MarcelRankwiler/TP21/OwnCars/21286/Chassis.png

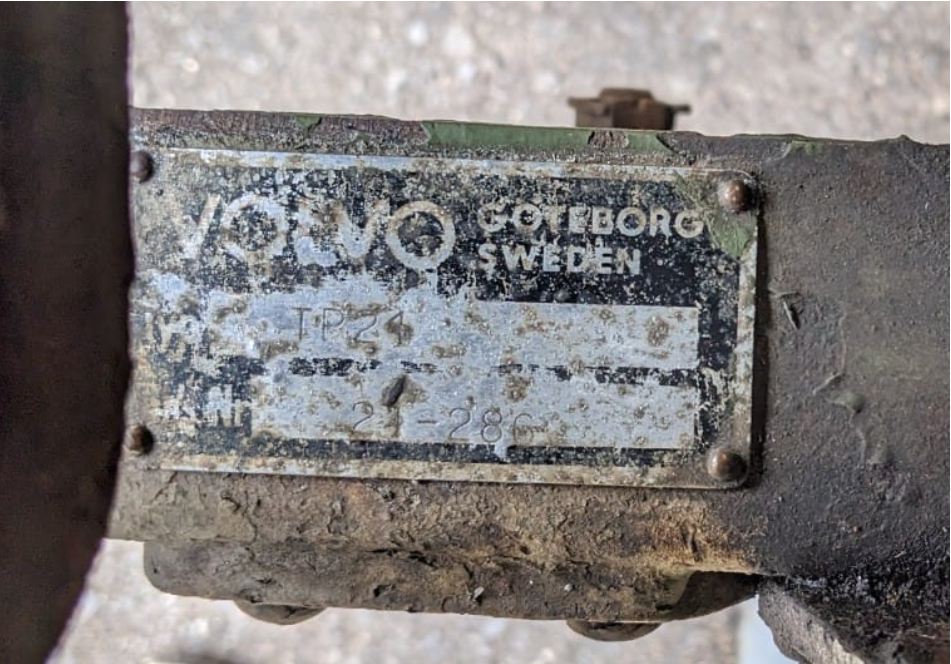
OwnCars/21286/Chassis.png
