MarcelRankwiler/TP21/Pictures/Fusebox.jpg

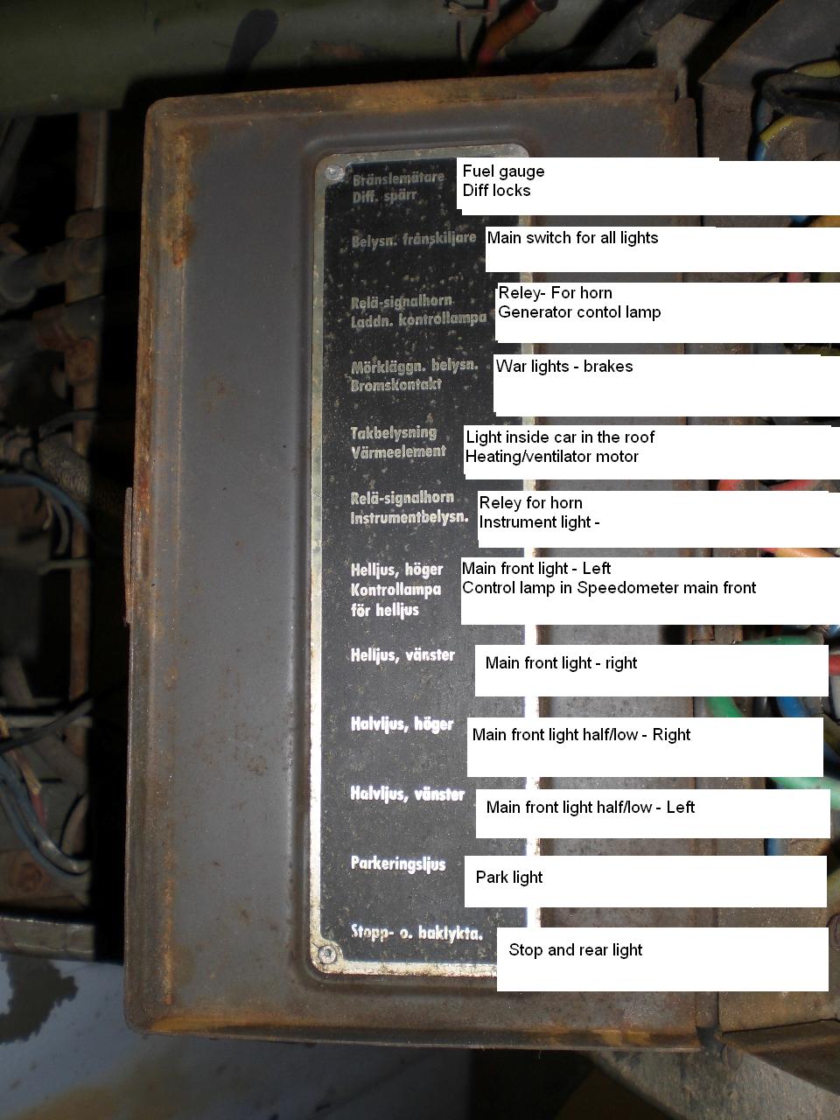
Pictures/Fusebox.jpg
