MarcelRankwiler/TP21/OwnCars/21286/21286.pdf

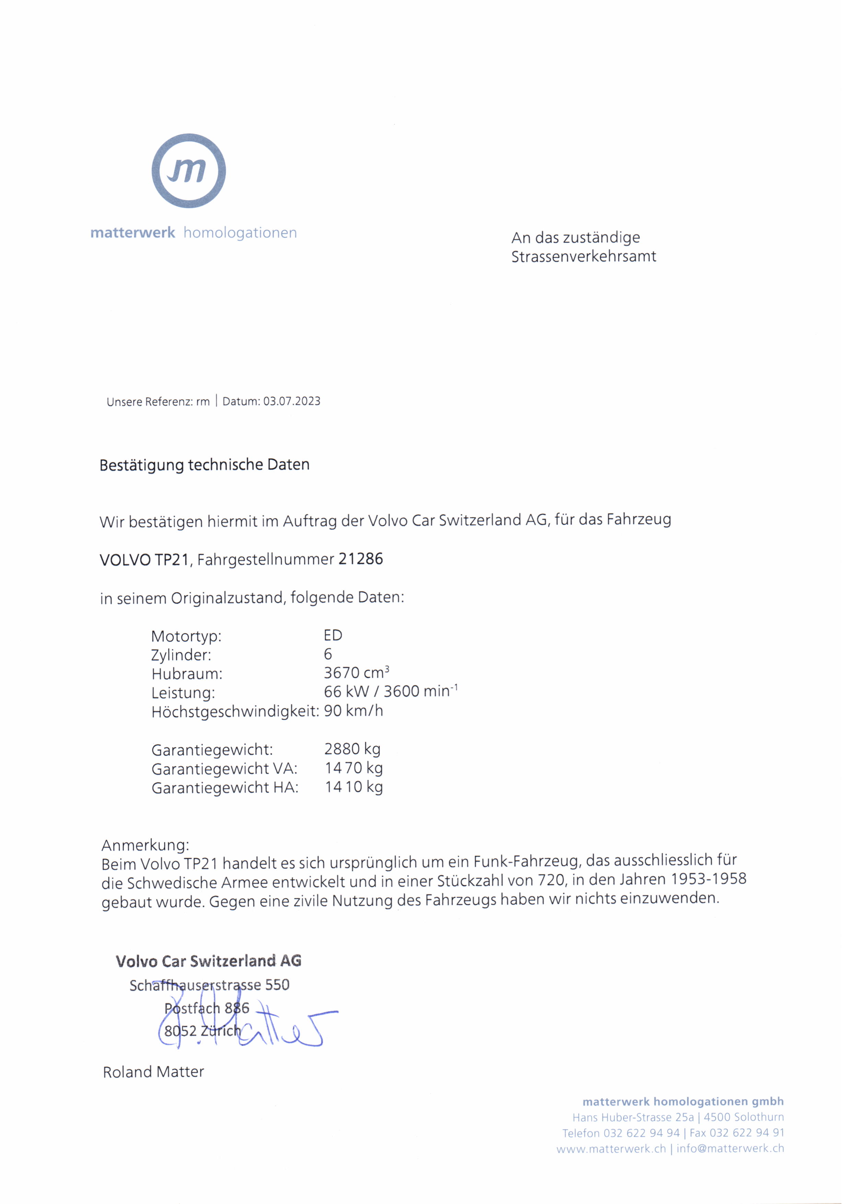
[picture p21: page 1]
