MarcelRankwiler/TP21/Newspaper/4wd_1988_no_3.pdf

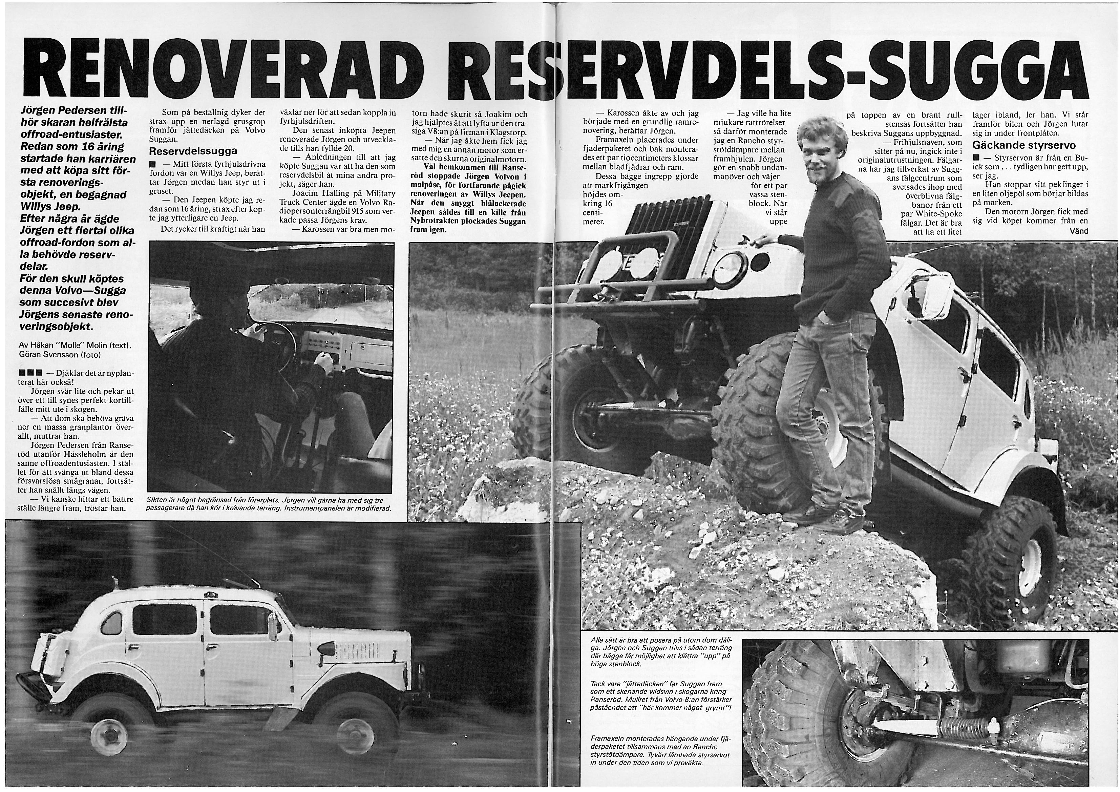
[picture p22: page 1]
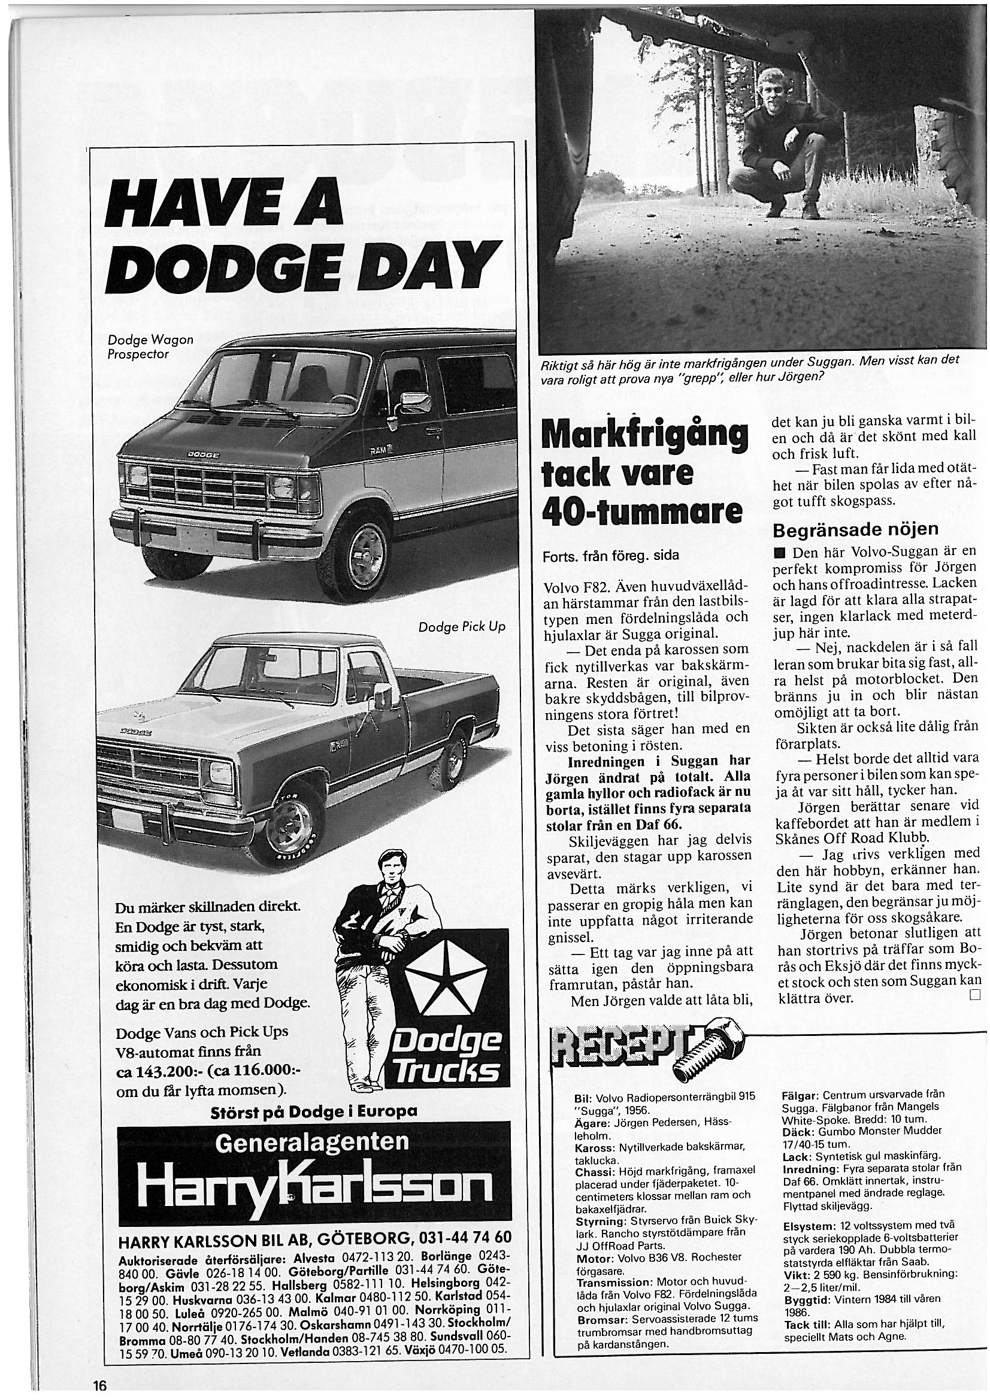
[picture p23: page 2]
