MarcelRankwiler/TP21/Newspaper/cmv_contributions.pdf

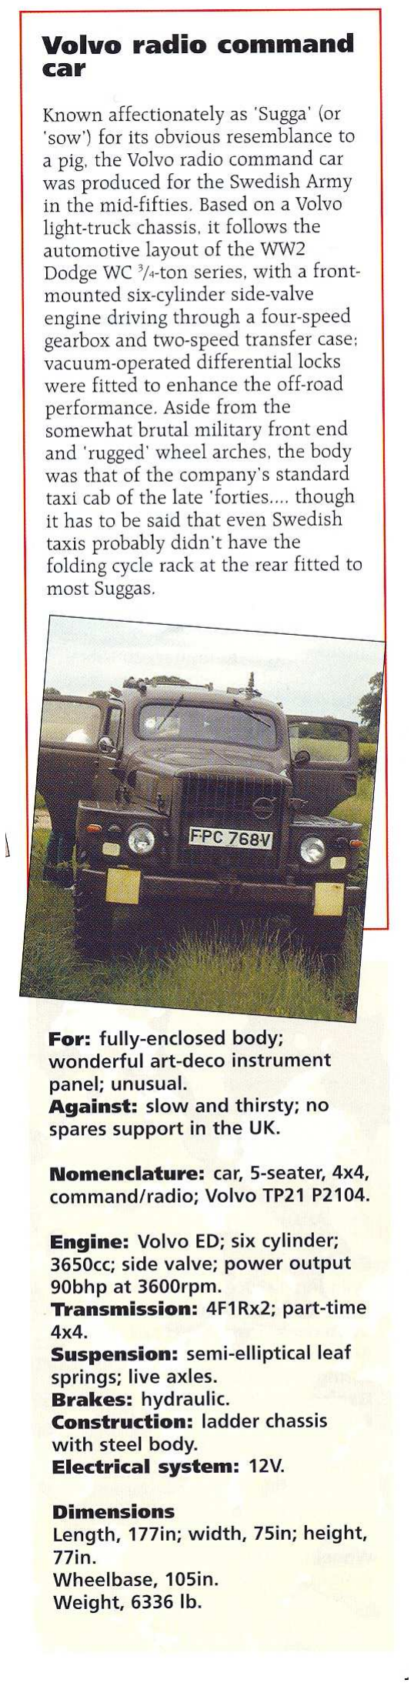
[picture p24: figure]
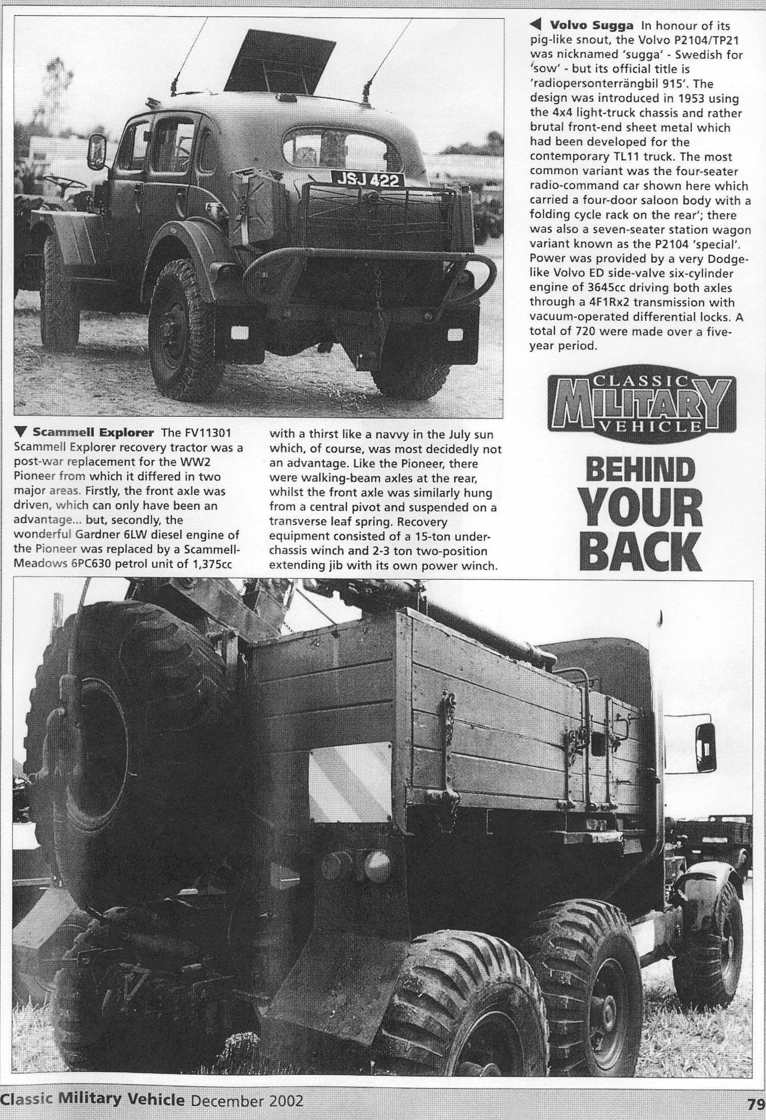
[picture p25: page 2]
