MarcelRankwiler/TP21/Archiv/Ersatzteile/motor.txt

Volvo b36 is an easy swap into sugga. they use same boltpattern on the gearbox. You need to make some new motormounts. But it is hard too find a b36 in working order for a good price. And hard too find part for it.  A b30 is mutch more easy to find. But it will not fit on the original gearbox. A lot of machine work needed to make it fit.  Many people mount volvo td40 dieselengine and gearbox into sugga. A good alternative is also a chevy smallblock and auto transmission. You make new motormounts and a short axle for make it fit on the original transfercase. Some people has also used rover 3,5 liter v8 and gearbox in them.
