MarcelRankwiler/TP21/Archiv/Ersatzteile/Motorhauben zuhalter.txt

https://rennsportshop.com/
Schlüter Motorsport
Tel.: 0 59 32 903 540 • (Mo-Fr 09:30-12:00 / 14:00-17:00)

034-503642
https://www.rennsportshop.com/de-fahrzeug-technik-karosserie-zubehoer-haubenhalter-034-503642-Haubenhalter-Gummi-gro.html

HAUBENHALTER GUMMI GROSS (GE63

Grayston
WES22-0489

EAN 4061322102359
