MarcelRankwiler/TP21/Archiv/Ersatzteile/v8 motor und bremsen infos.txt

V8 Motor: B36 Volvo
Bremsen 2x Bremskraftverstärker von Volvo C303-306. Verstärker müssen nicht am Pedal sein.
Original Radzylinder LOCKHEED 1 1/4 29260/2
Radbremszylinder: Japanparts CS-285 Radbremszylinder für TOYOTA Land Cruiser 40 SUV (J40, J50)
Radbremszylinder nicht lieferbar, daher: CS-286 
Kork bei Motortrennwand: Holzboden Dämmmaterial in Kunstharz tränken

Haubenauflage 2K Sikaflex. Löcher zuschweissen.

Felgen: STANKEY 3265

Dichtungen Aufstellfenster: Volvo 544 -> 8890 656030

Reifen: Michelin 11/16R
