MarcelRankwiler/TP21/OwnCars/21286/b9a44b88-bfe5-4032-885c-819699b52672.jpg

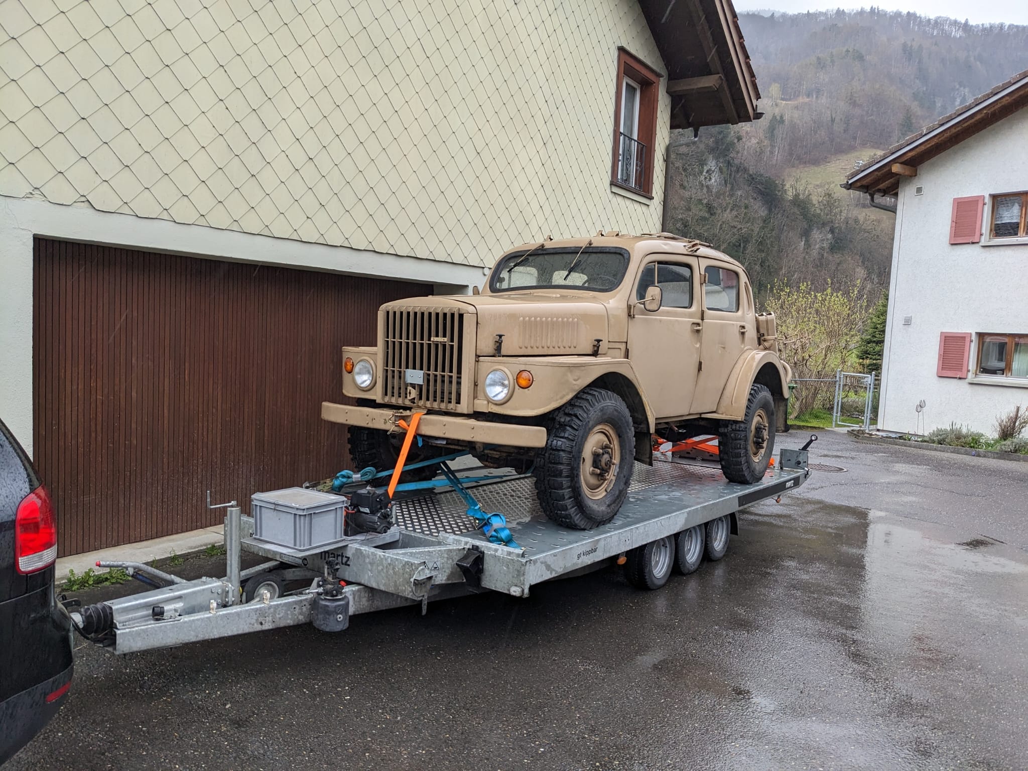
OwnCars/21286/b9a44b88-bfe5-4032-885c-819699b52672.jpg
