MarcelRankwiler/TP21/OwnCars/21286/Motor.png

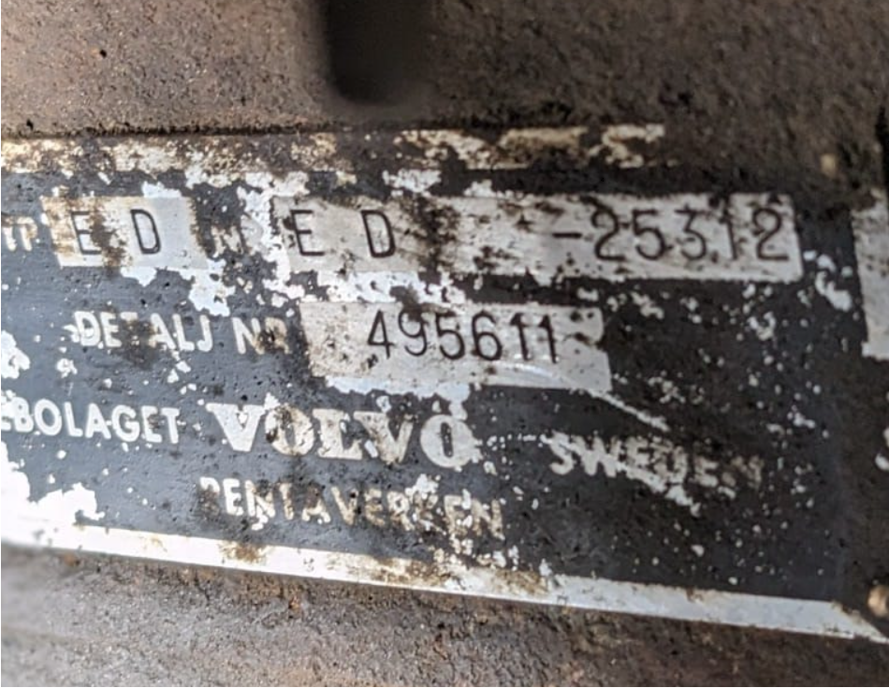
OwnCars/21286/Motor.png
