MarcelRankwiler/TP21/OwnCars/21286/Motorraum.png

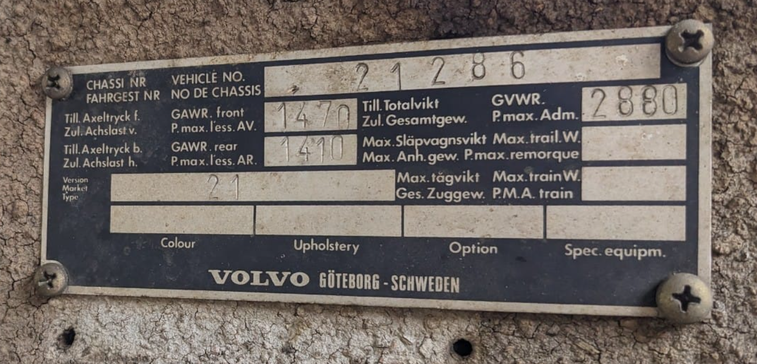
OwnCars/21286/Motorraum.png
