MarcelRankwiler/TP21/OwnCars/21286/PXL_20230614_184519926.jpg

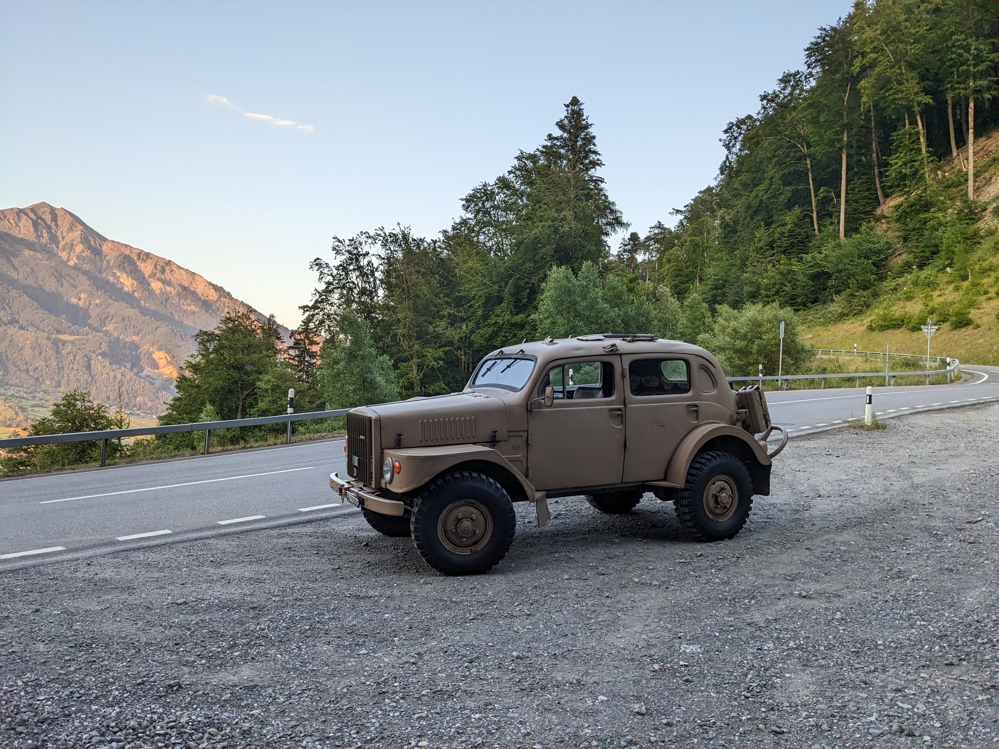
OwnCars/21286/PXL_20230614_184519926.jpg
