MarcelRankwiler/TP21/OwnCars/21286/WhatsApp Image 2023-05-04 at 12.50.00.jpeg

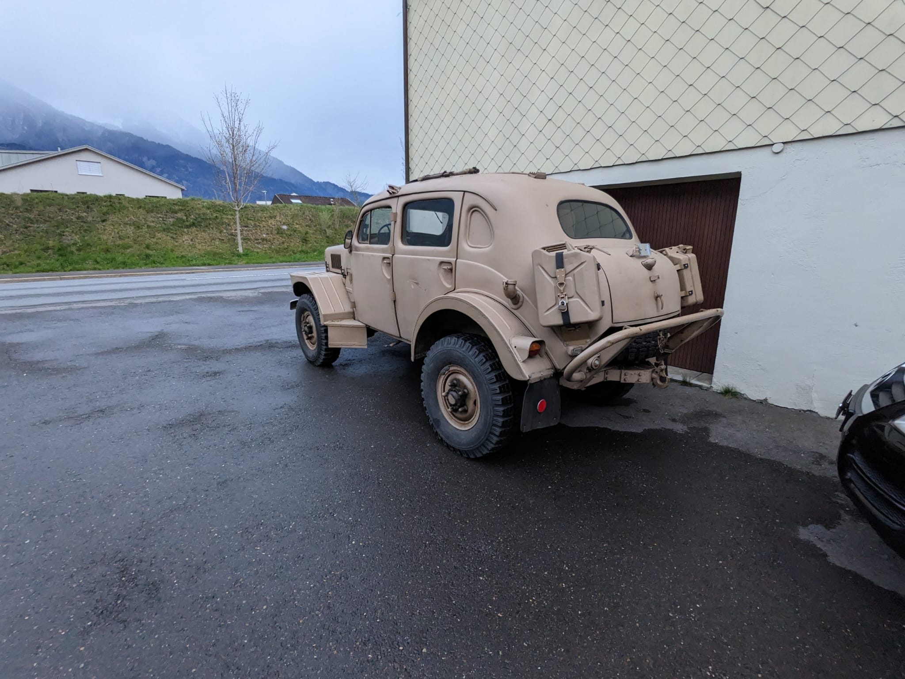
OwnCars/21286/WhatsApp Image 2023-05-04 at 12.50.00.jpeg
