MarcelRankwiler/TP21/OwnCars/unbekannt/1.jpg

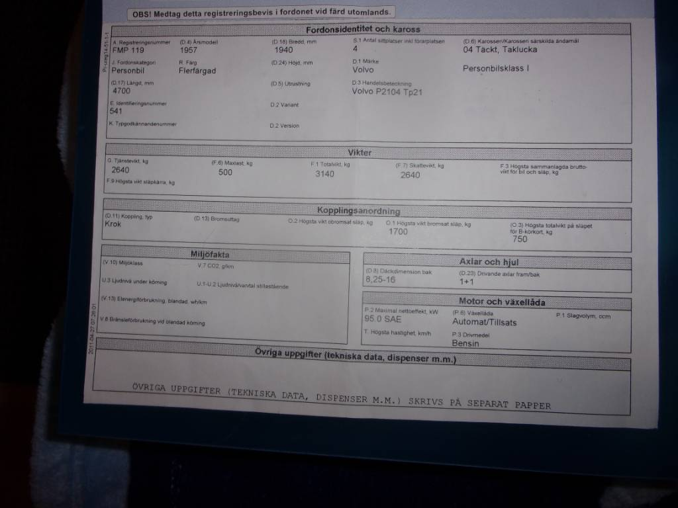
OwnCars/unbekannt/1.jpg
