MarcelRankwiler/TP21/OwnCars/unbekannt/2.jpg

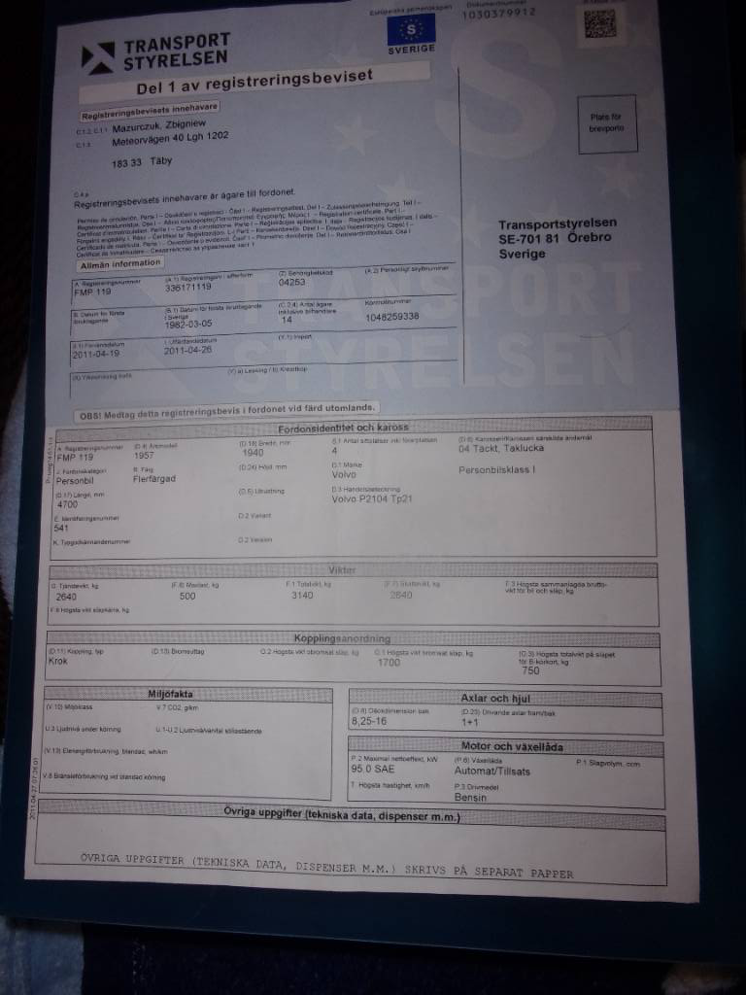
OwnCars/unbekannt/2.jpg
