MarcelRankwiler/TP21/OwnCars/unbekannt/3.jpg

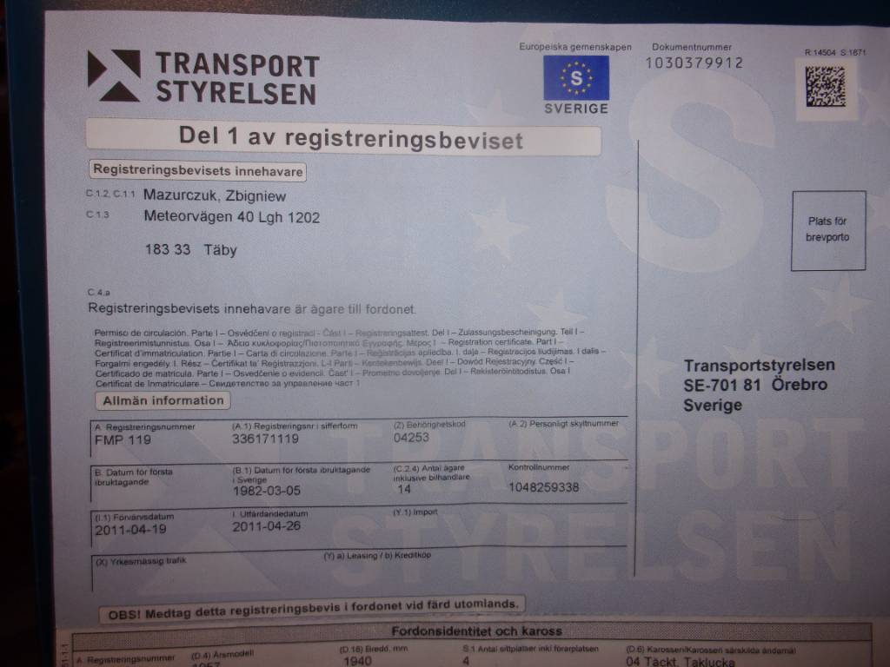
OwnCars/unbekannt/3.jpg
