MarcelRankwiler/TP21/OwnCars/unbekannt/4.jpg

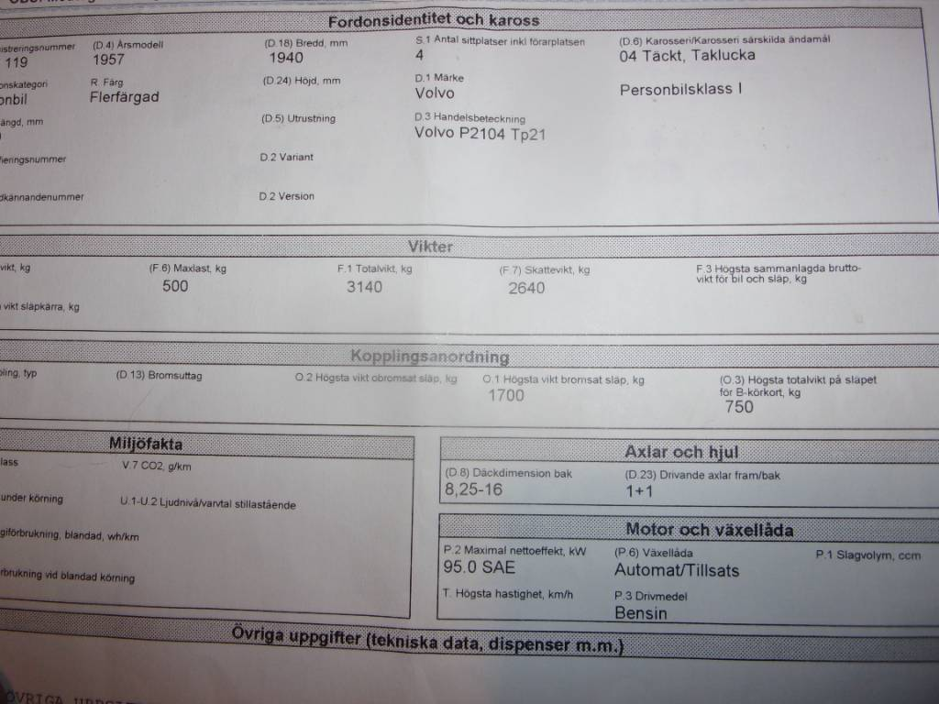
OwnCars/unbekannt/4.jpg
