MarcelRankwiler/TP21/OwnCars/unbekannt/5.jpg

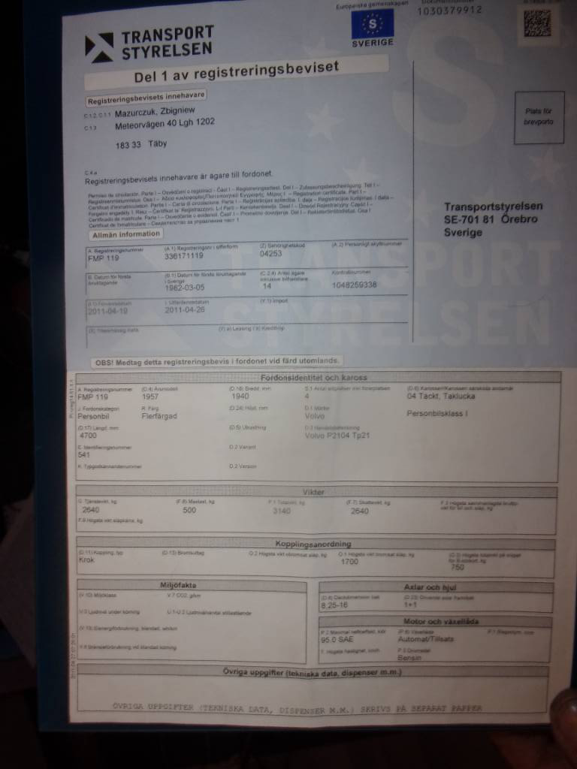
OwnCars/unbekannt/5.jpg
