MarcelRankwiler/TP21/OwnCars/unbekannt/6.jpg

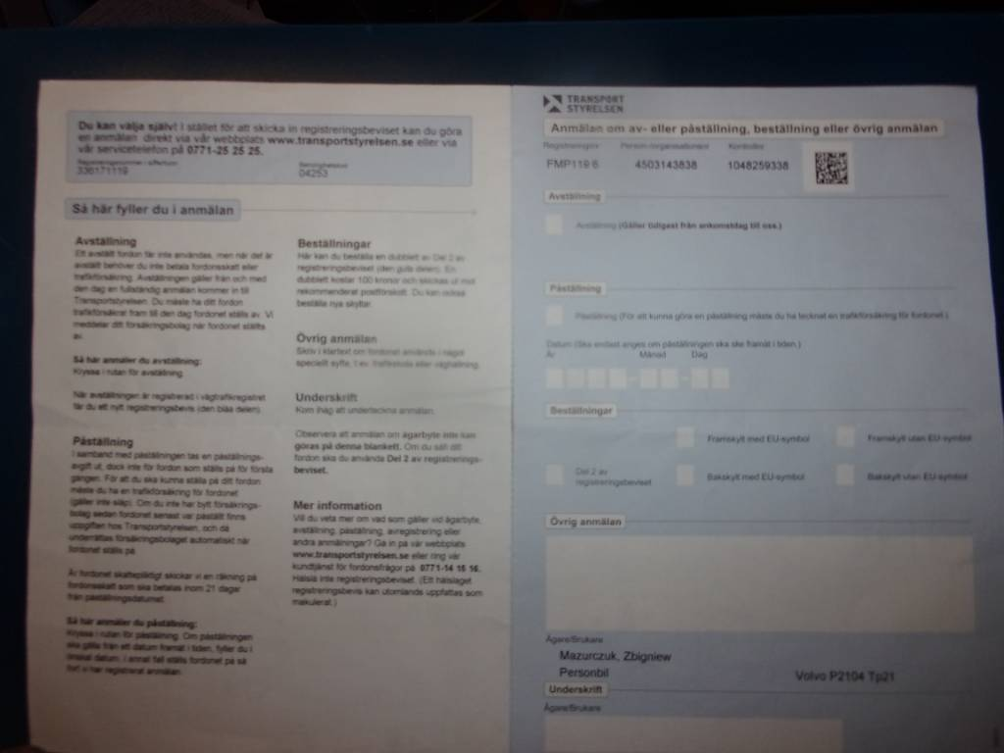
OwnCars/unbekannt/6.jpg
