MarcelRankwiler/TP21/OwnCars/unbekannt/2022-03-30_10h43_52.png

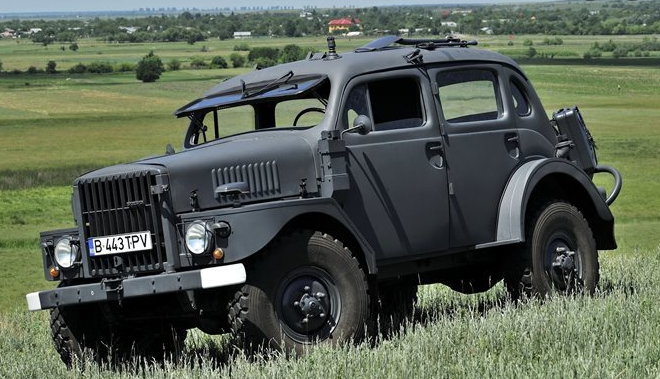
OwnCars/unbekannt/2022-03-30_10h43_52.png
