MarcelRankwiler/TP21/Pictures/Speed table.jpg

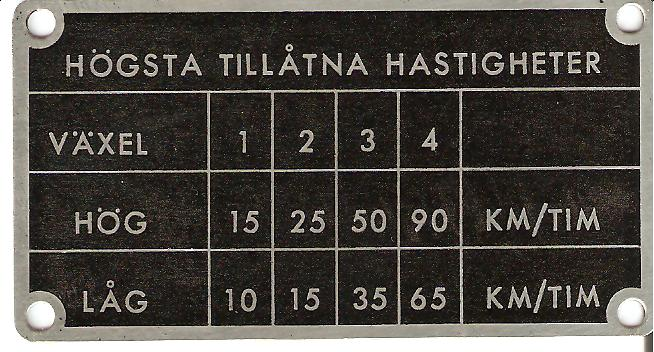
Pictures/Speed table.jpg
