MarcelRankwiler/TP21/DesignFiles/Dichtungen/TP21/Achsen/Bestellen/Tool_Radlager_Einpressen.DXF

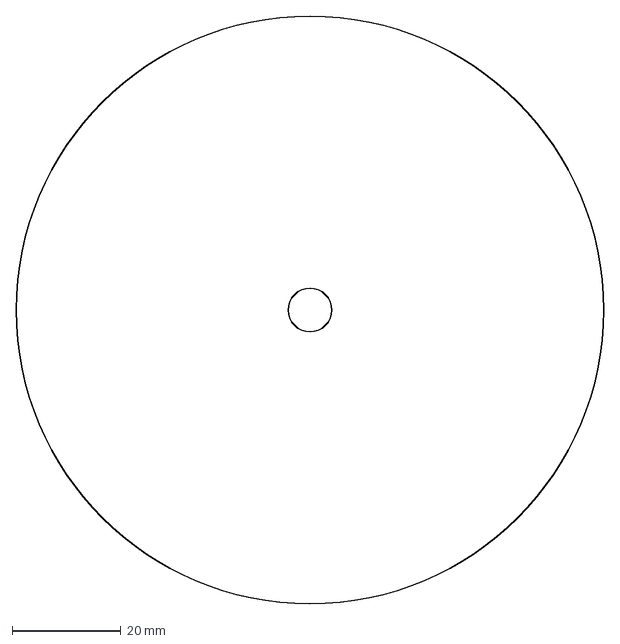
[picture p40: CAD file, 2023-07-09]
DesignFiles/Dichtungen/TP21/Achsen/Bestellen/Tool_Radlager_Einpressen.DXF
108.0 x 108.0 mm
