MarcelRankwiler/TP21/DesignFiles/Dichtungen/TP21/Achsen/Bestellen/Tool_Radlager_Auspressen_8mm.DXF

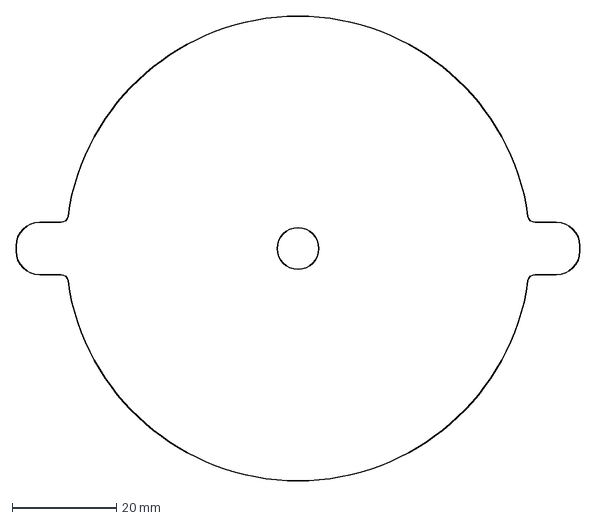
[picture p41: CAD file, 2023-07-09]
DesignFiles/Dichtungen/TP21/Achsen/Bestellen/Tool_Radlager_Auspressen_8mm.DXF
108.0 x 89.0 mm
