MarcelRankwiler/TP21/DesignFiles/Dichtungen/TP21/Achsen/Bestellen/Radmutter_Arretierring.DXF

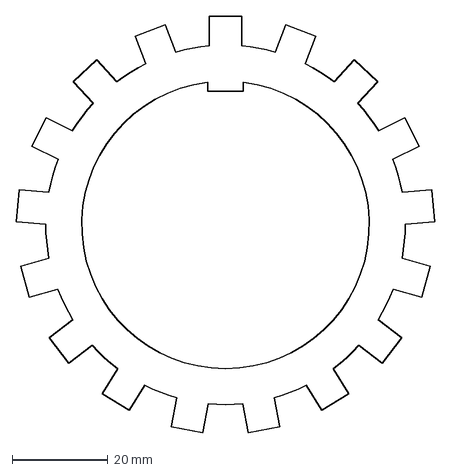
[picture p42: CAD file, 2023-07-09]
DesignFiles/Dichtungen/TP21/Achsen/Bestellen/Radmutter_Arretierring.DXF
87.2 x 86.9 mm
