MarcelRankwiler/TP21/DesignFiles/Dichtungen/TP21/Achsen/SealingTP21_FrontAxle2_ver2.SLDPRT

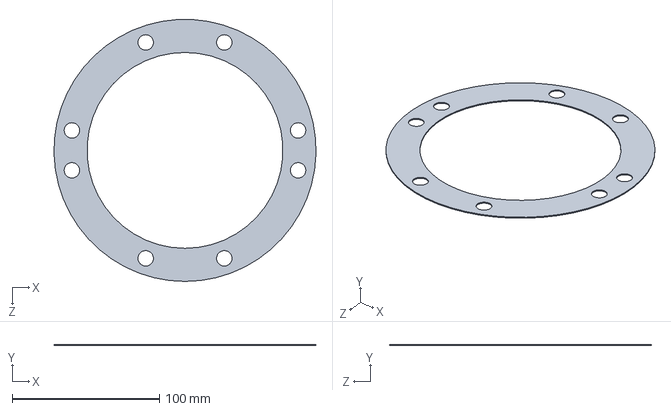
[picture p43: CAD file, 2023-07-09, an earlier design]
DesignFiles/Dichtungen/TP21/Achsen/SealingTP21_FrontAxle2_ver2.SLDPRT
177.9 x 0.737 x 177.8 mm
