MarcelRankwiler/TP21/(list of files, cad)

Other CAD files:
DesignFiles/Dichtungen/TP21/Bremssystem/HBZ Adapter.SLDPRT
DesignFiles/Dichtungen/TP21/Kühlsystem/DichtungThermostatgehäuse.SLDPRT
DesignFiles/Dichtungen/TP21/Achsen/Tool_Radlager_Einpressen_106mm.SLDPRT
DesignFiles/Dichtungen/TP21/Achsen/SealingTP21_FrontAxle2_ver6_ohneHilfslinien.SLDPRT
DesignFiles/Dichtungen/TP21/Achsen/SealingTP21_FrontAxle2_ver5.SLDPRT
DesignFiles/Dichtungen/TP21/Achsen/Tool_Radlager_Auspressen_8mm.SLDPRT
DesignFiles/Dichtungen/TP21/Achsen/SealingTP21_FrontAxle2.SLDPRT
DesignFiles/Dichtungen/TP21/Achsen/Radmutter_Arretierring.SLDPRT
DesignFiles/Dichtungen/TP21/Achsen/SealingTP21_Axle.SLDPRT
DesignFiles/Dichtungen/TP21/Achsen/Tool_Radlager_Einpressen.SLDPRT
Archiv/Ersatzteile/achsdichtungen/Achsen/Tool_Radlager_Einpressen.SLDPRT
Archiv/Ersatzteile/achsdichtungen/Achsen/SealingTP21_Axle.SLDPRT
Archiv/Ersatzteile/achsdichtungen/Achsen/Tool_Radlager_Auspressen_8mm.SLDPRT
DesignFiles/Dichtungen/TP21/Achsen/SealingTP21_FrontAxle2_ver5_ohneHilfslinien.SLDPRT
Archiv/Ersatzteile/achsdichtungen/Achsen/SealingTP21_Axle.DXF
Archiv/Ersatzteile/achsdichtungen/Achsen/Tool_Radlager_Auspressen_8mm.DXF
Archiv/Ersatzteile/achsdichtungen/Achsen/Tool_Radlager_Einpressen.DXF
DesignFiles/Dichtungen/TP21/Achsen/SealingTP21_Axle.DXF
DesignFiles/Dichtungen/TP21/Achsen/SealingTP21_FrontAxle2.DXF
DesignFiles/Dichtungen/TP21/Achsen/SealingTP21_FrontAxle2_ver3.SLDPRT
DesignFiles/Dichtungen/TP21/Achsen/SealingTP21_FrontAxle2_ver4.SLDPRT
DesignFiles/Dichtungen/TP21/Achsen/SealingTP21_FrontAxle2_ver5.DWG
DesignFiles/Dichtungen/TP21/Achsen/SealingTP21_FrontAxle2_ver5.DXF
DesignFiles/Dichtungen/TP21/Achsen/SealingTP21_FrontAxle2_ver6_ohneHilfslinien.DXF
DesignFiles/Dichtungen/TP21/Achsen/Tool_Radlager_Auspressen_8mm.DXF
DesignFiles/Dichtungen/TP21/Achsen/Tool_Radlager_Einpressen.DXF
DesignFiles/Dichtungen/TP21/Achsen/Tool_Radlager_Einpressen_106mm.DXF
DesignFiles/Dichtungen/TP21/Bremssystem/HBZ Adapter.DXF
DesignFiles/Dichtungen/TP21/Kühlsystem/DichtungThermostatgehäuse.DXF
DesignFiles/Dichtungen/test.SLDDRW
