MarcelRankwiler/TP21/OtherManuals/dashboard_center.pdf

Lights switch :
- left : dim lights,
- center : off,
- right : side marker
lights.

Power light

Power key

Windscreen waterpump
switch

Indicator light (flashing yellow)

Indicator switch :
- left : turn left
- center : off,
- right : turn right.

Heater fan switch

Reverse light (purple)

Reverse gear engaged
switch

Ignition button

Hand throttle command

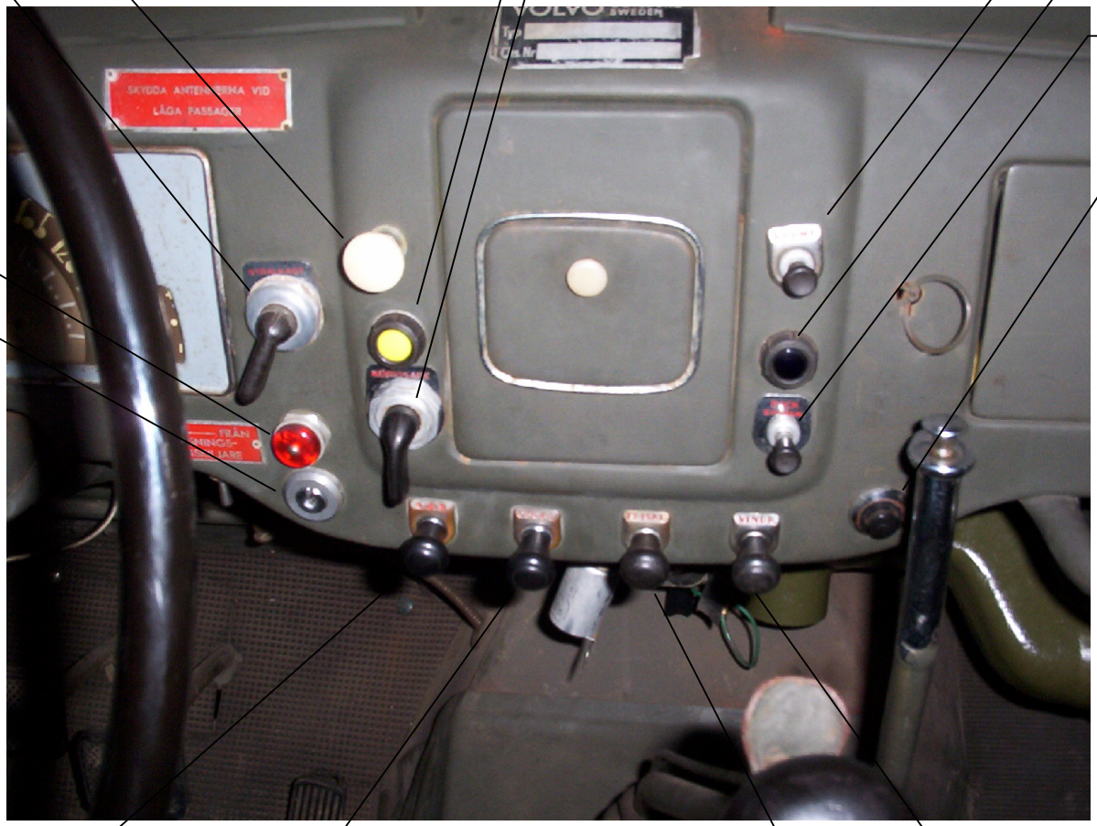
[picture p47: figure]

Choke command | Outer air vent command Heated air to the windscreen command
