MarcelRankwiler/TP21/OwnManuals/DE_Austausch_Dichtring_Achsgehäuse_vorne_v01.docx

Auswechseln des Dichtungsrings im Achsgehäuse

Zeitaufwand ca. 7 Stunden

Spezielles Werkzeug:

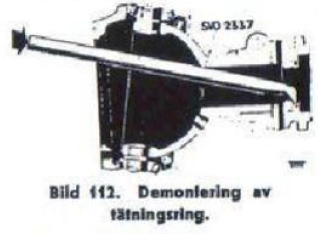
[picture p48: figure]

SVO 2000 Standardbacke

SVO 2361 Montagewerkzeug für Dichtungsring

SVO 2337 Demontagewerkzeug für Dichtungsring

SVO 2354 Schlüssel für Lesemuttern, Radnaben

SVO 2355 Abzieher für Radnaben

SVO 2356 Abzieher für Radinnenlager

SVO 2362 Messgerät

SVO 2357 Montagedorn für Dichtring in Radnaben

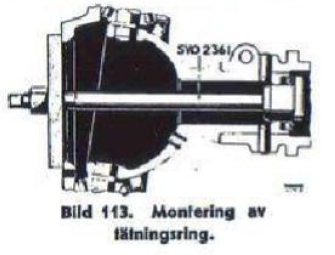
[picture p49: figure]

1. Das Vorderachsgetriebe ausbauen, siehe unter "Vorderachsgetriebe auswechseln" Seite 77.

2. den Dichtungsring mit dem Spanndorn SVO 2337 herausschlagen (Abb. 112).

3. den Dichtring mit dem Werkzeug SVO 2361 einbauen, wie in Abbildung 113 gezeigt.

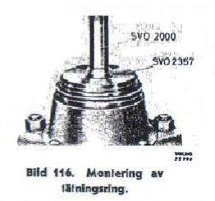
[picture p50: figure]

4. Die anderen Teile in umgekehrter Reihenfolge der Demontage montieren. Drücken Sie den Nabendichtring wie in Abbildung 116 gezeigt ein. Füllen Sie das Vorderachsgehäuse mit Öl. Schmieren Sie die Rzeppa-Knoten.
