MarcelRankwiler/TP21/OtherManuals/dashboard_left_side.pdf

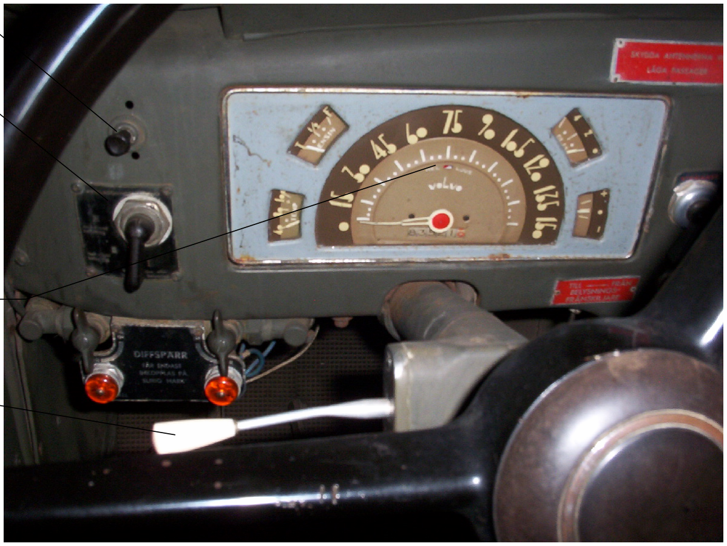
[picture p52: figure]

?
Doesn’ t seem to work

?
Doesn’ t seem to work

High beam light (permanent red)

High beam command
