MarcelRankwiler/TP21/OtherManuals/msy-S0001_radiator_blind_system.pdf

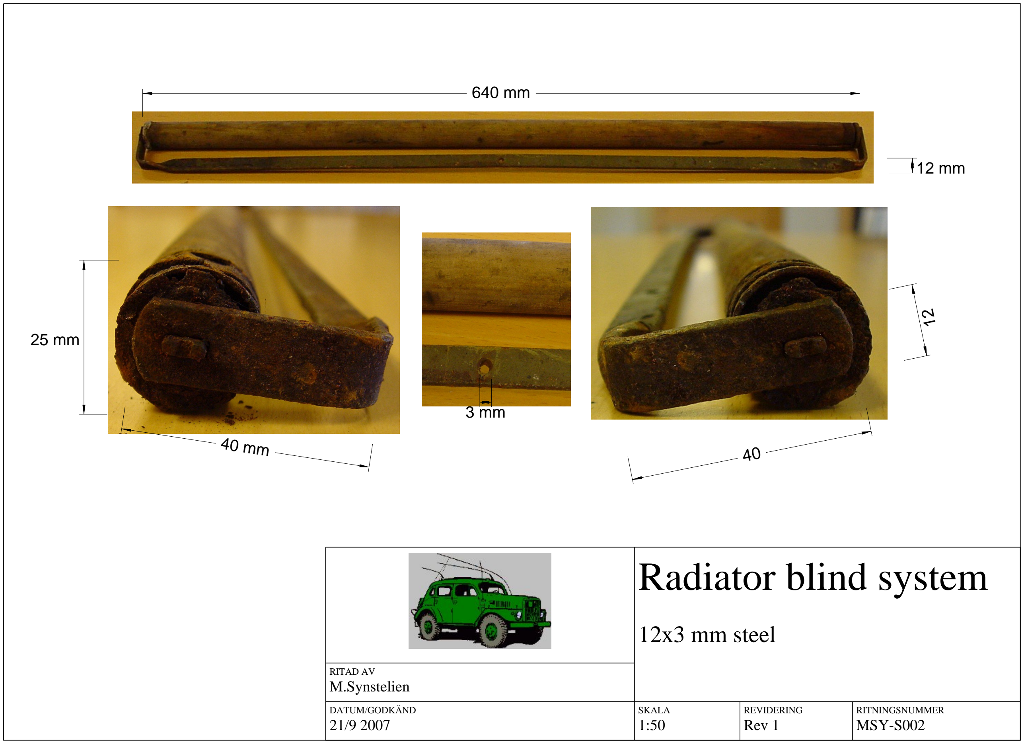
[picture p53: figure]
RITAD AV M.Synstelien; DATUM/GODKÄND 21/9 2007; SKALA 1:50; REVIDERING Rev 1; RITNINGSNUMMER MSY-S002; Radiator blind system; 12x3 mm steel
