MarcelRankwiler/TP21/Webpage/pdf/volvomanuals/SV_VolvoTP21_ServiceInterval1967.pdf

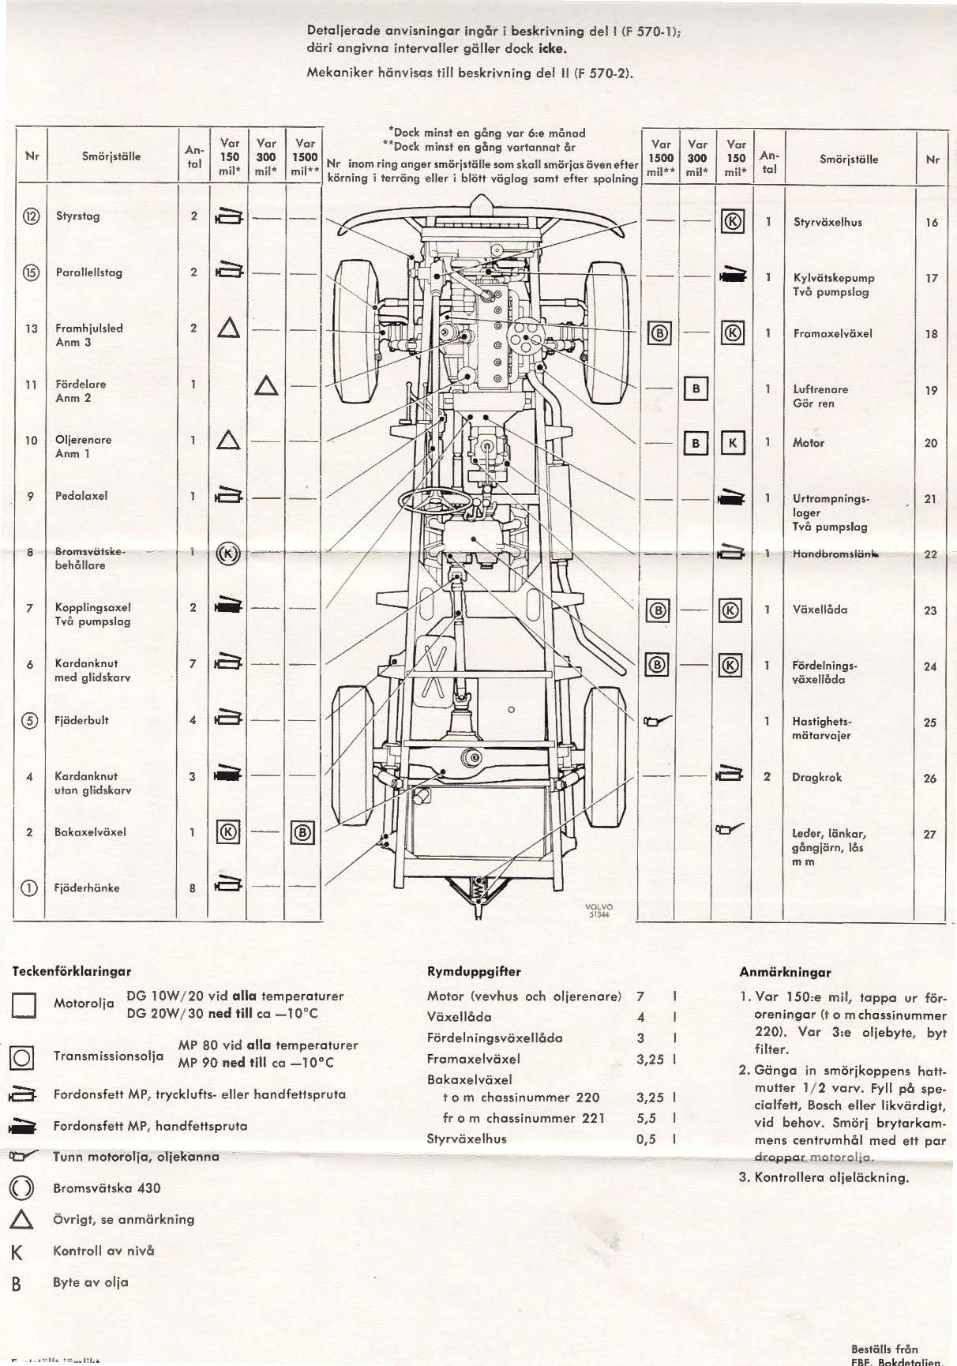
[picture p54: page 1]
