MarcelRankwiler/TP21/Webpage/pdf/volvomanuals/EN_VolvoTP21_ServiceInterval1967.pdf

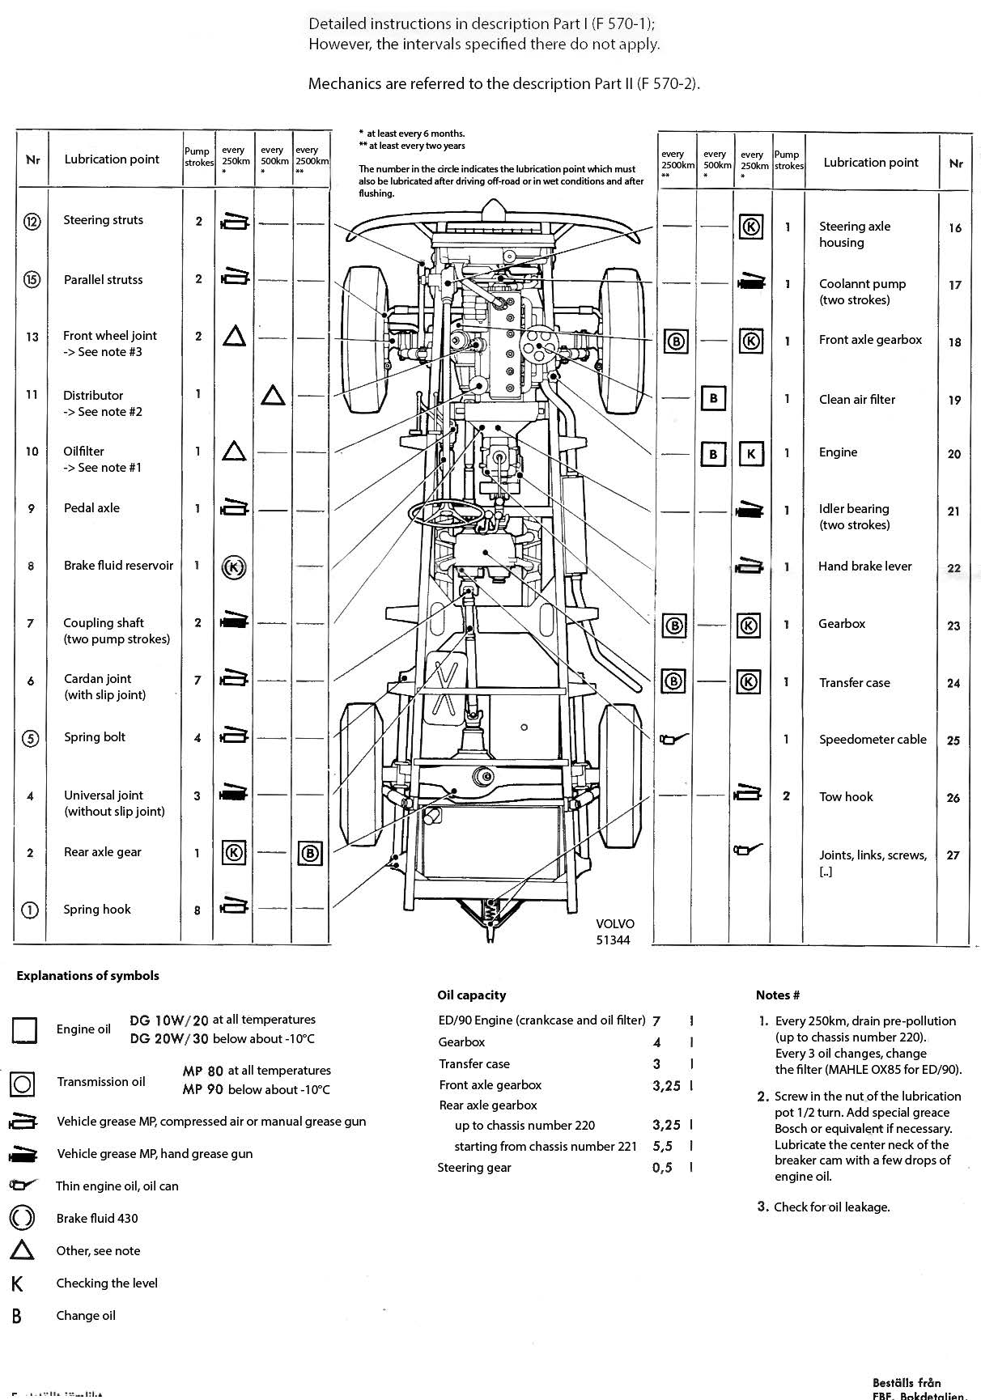
[picture p55: page 1]
