MarcelRankwiler/TP21/OwnManuals/FrontAxleSeal2.png

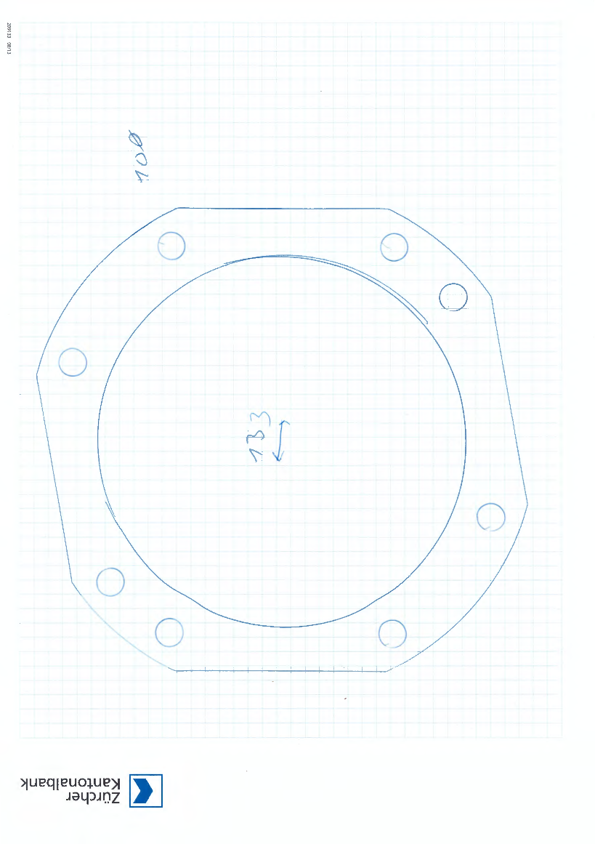
OwnManuals/FrontAxleSeal2.png
