MarcelRankwiler/TP21/OwnManuals/Gewinde Benzinleitung.png

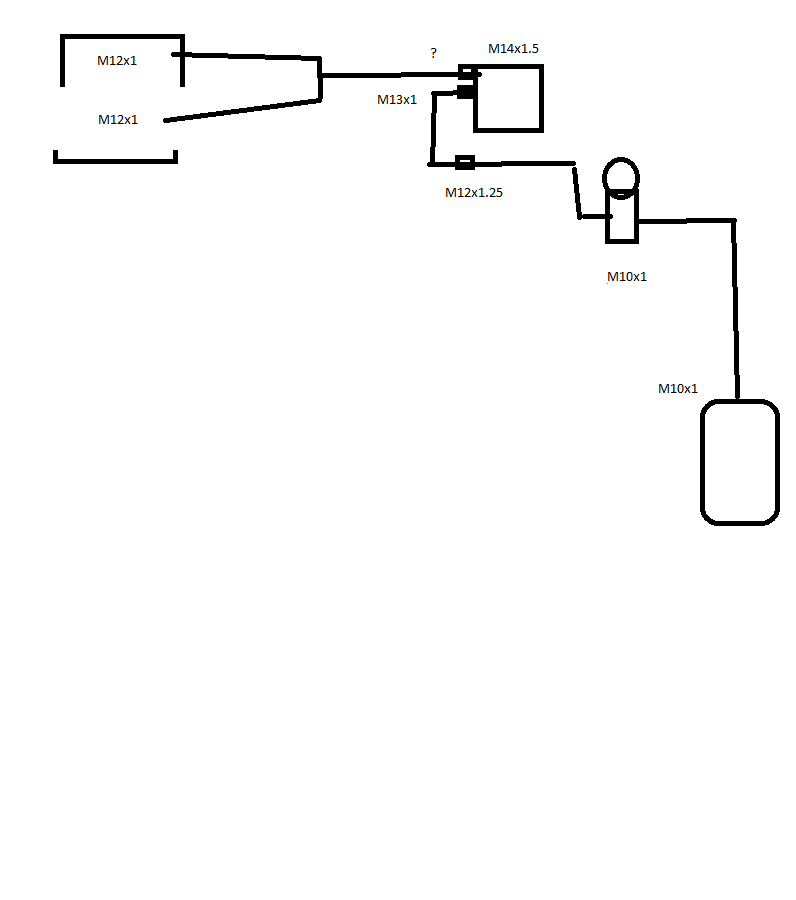
OwnManuals/Gewinde Benzinleitung.png
