MarcelRankwiler/TP21/DesignFiles/Dichtungen/TP21/Achsen/SealingTP21_Axle2.pdf

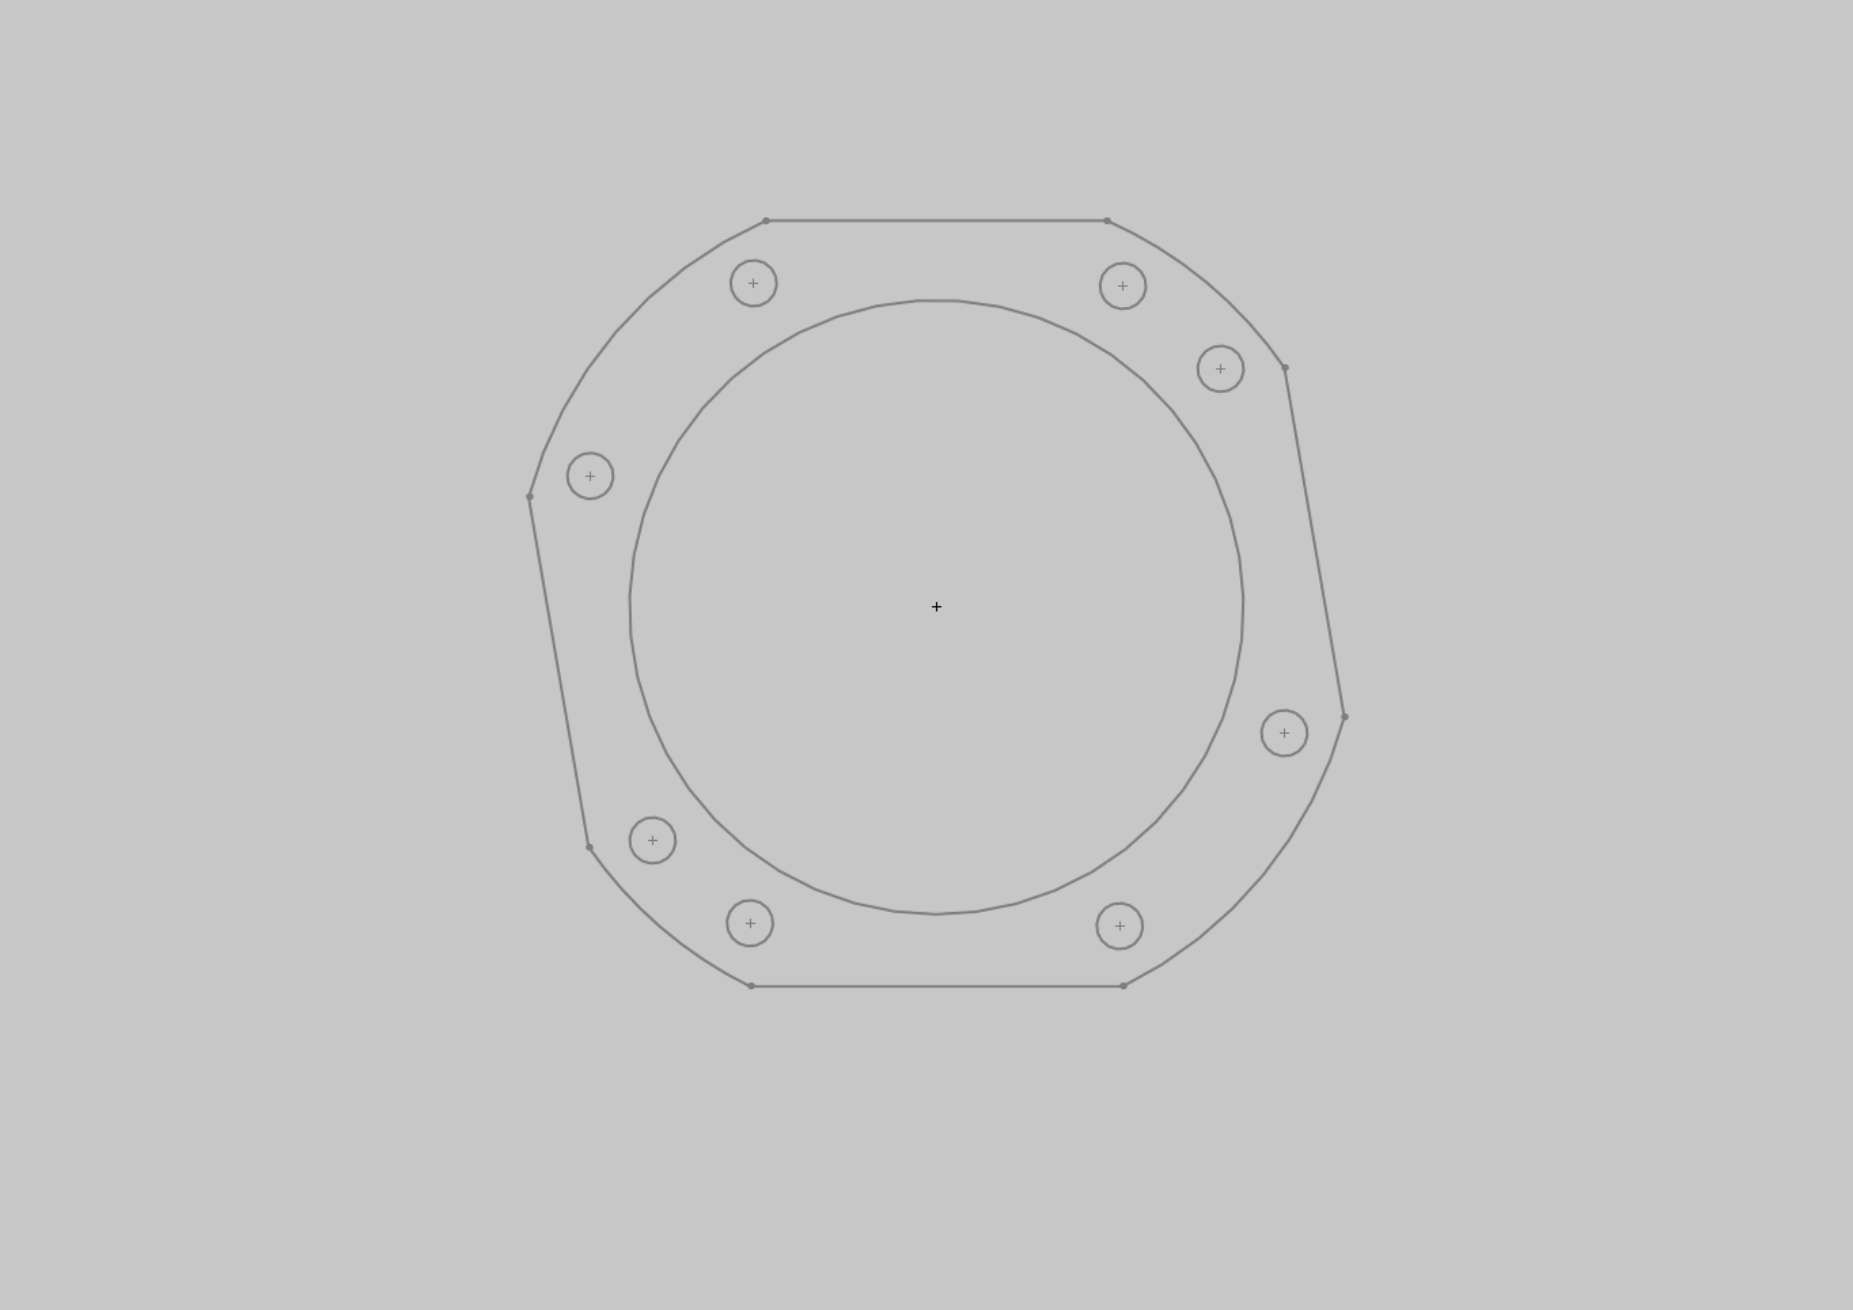
[picture p58: page 1]
