MarcelRankwiler/TP21/DesignFiles/Dichtungen/TP21/Achsen/SealingTP21_FrontAxle2.pdf

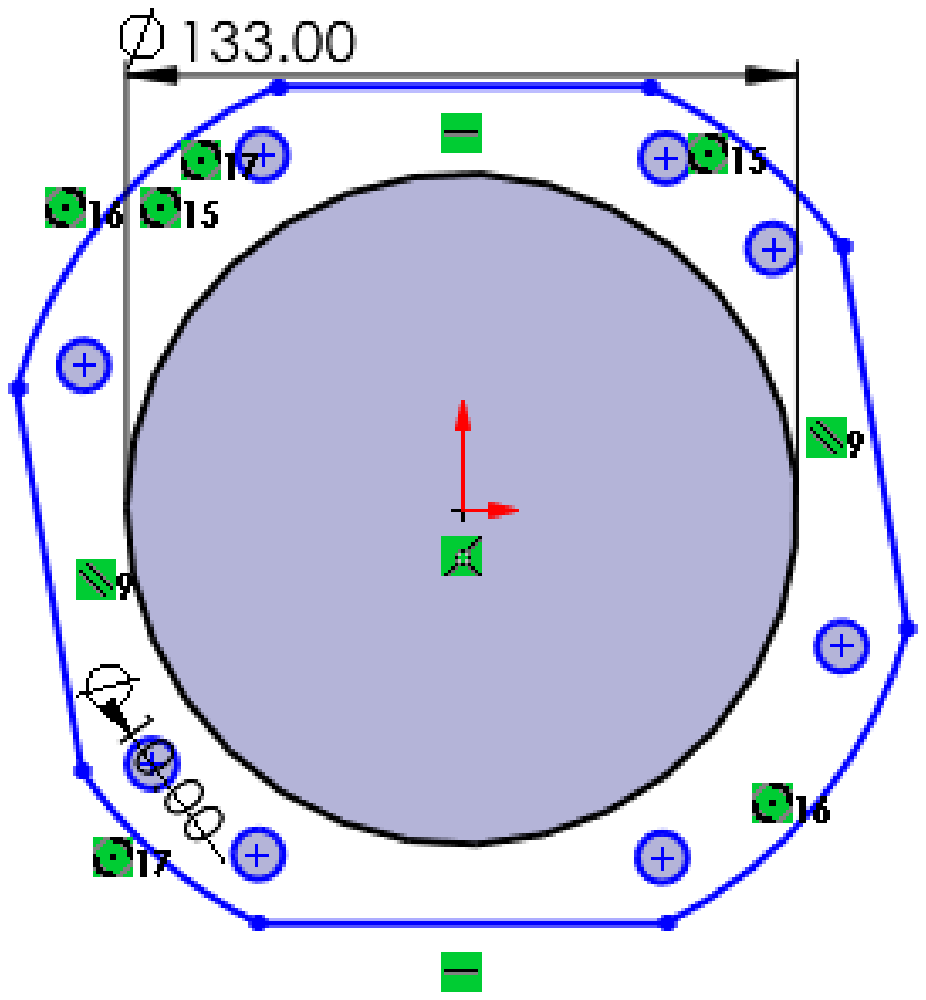
[picture p59: page 1]
