MarcelRankwiler/TP21/DesignFiles/Dichtungen/TP21/Achsen/SealingTP21_Axle.pdf

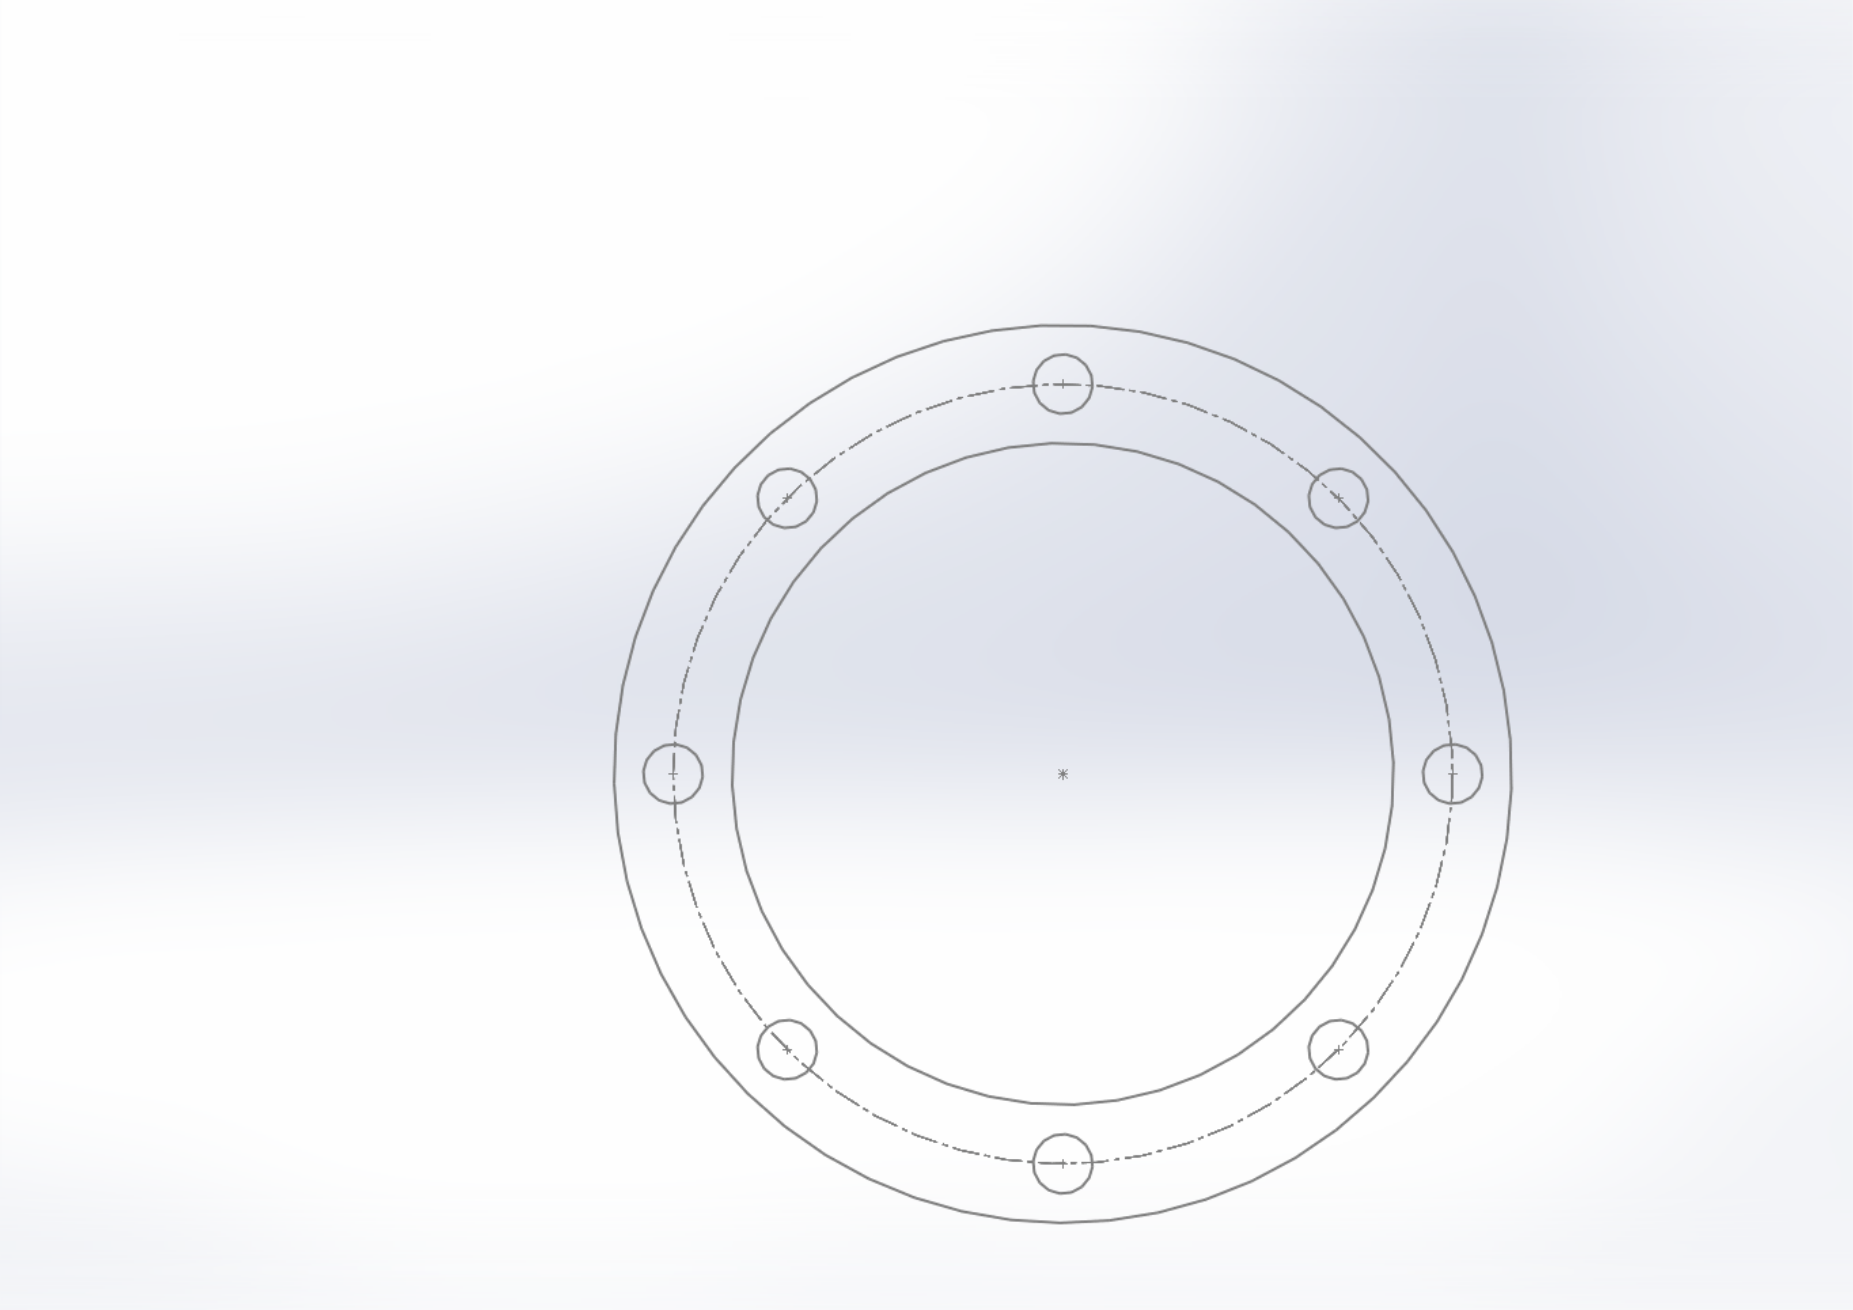
[picture p60: page 1]
