MarcelRankwiler/TP21/DesignFiles/Dichtungen/TP21/Achsen/test.PDF

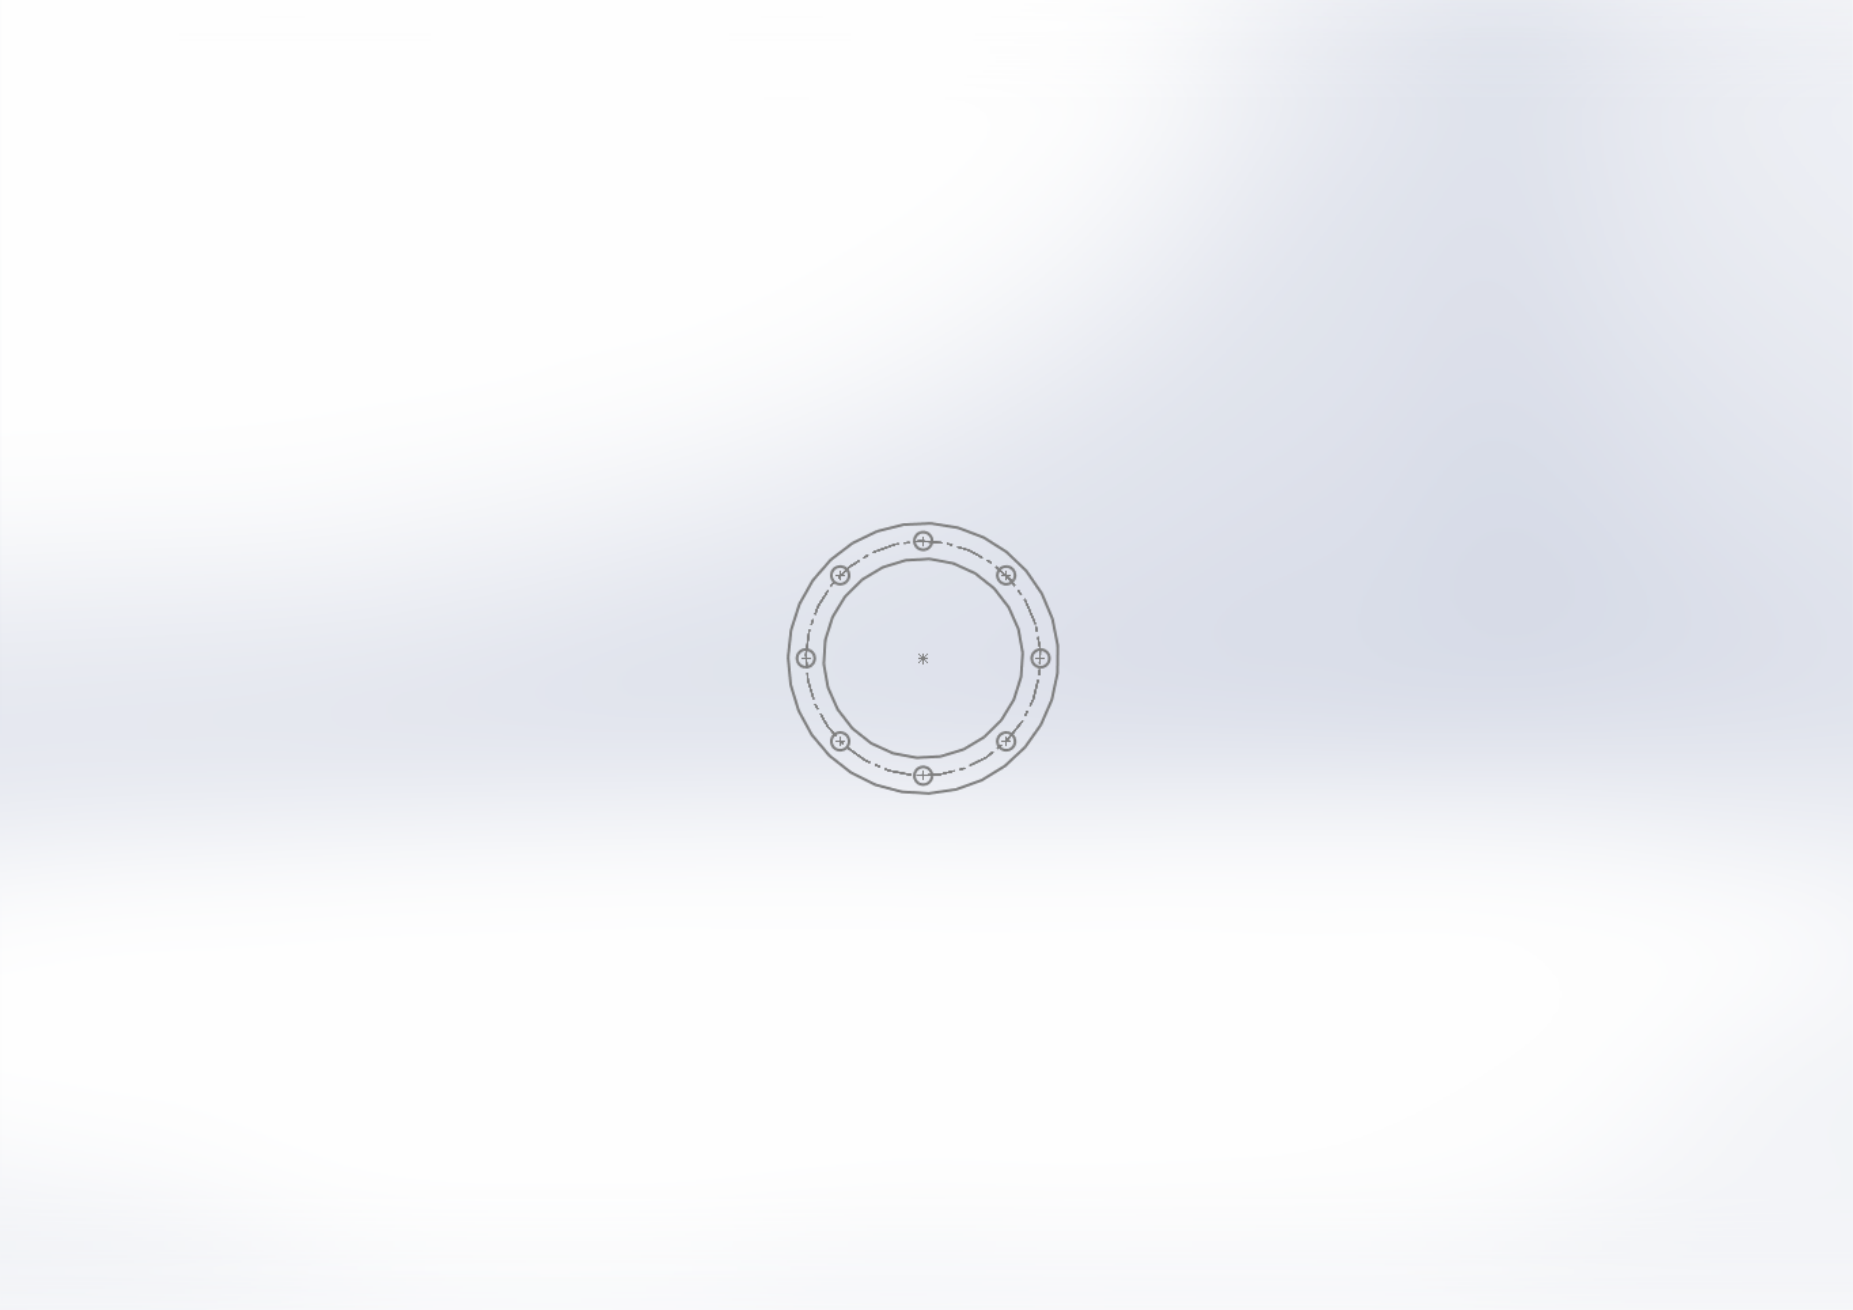
[picture p61: page 1]
