MarcelRankwiler/TP21/(commit log)

2023-07-07 Serval files added
    [Bremssystem_alt.xlsx, SealingTP21_Axle.DXF, SealingTP21_Axle.SLDPRT, Tool_Radlager_Auspressen_8mm.DXF, Tool_Radlager_Auspressen_8mm.SLDPRT, Tool_Radlager_Einpressen.DXF, Tool_Radlager_Einpressen.SLDPRT]
2023-07-07 Files added
    [Bremssystem.xlsx]
2023-07-07 Bremssystem überarbeitet
    [Bremssystem.xlsx, Bremssystem_alt.xlsx, DE_Bremsleitungen_Umbau_Metrisch_v01.xlsx]
2023-07-09 Added download content to website
    [DichtungThermostatgehäuse.DXF, DichtungThermostatgehäuse.SLDPRT, HBZ Adapter.DXF, HBZ Adapter.SLDPRT, Radmutter_Arretierring.DXF, Radmutter_Arretierring.SLDPRT, SealingTP21_Axle.DXF, SealingTP21_Axle.SLDPRT]
